ROXITX/tarp/docs/report/photos/photo_reader.jpg

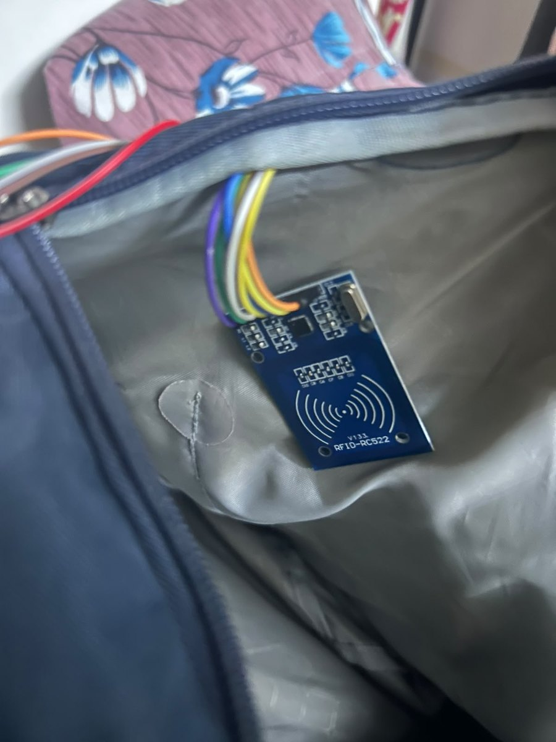
docs/report/photos/photo_reader.jpg
