ROXITX/tarp/docs/report/photos/photo_electronics.jpg

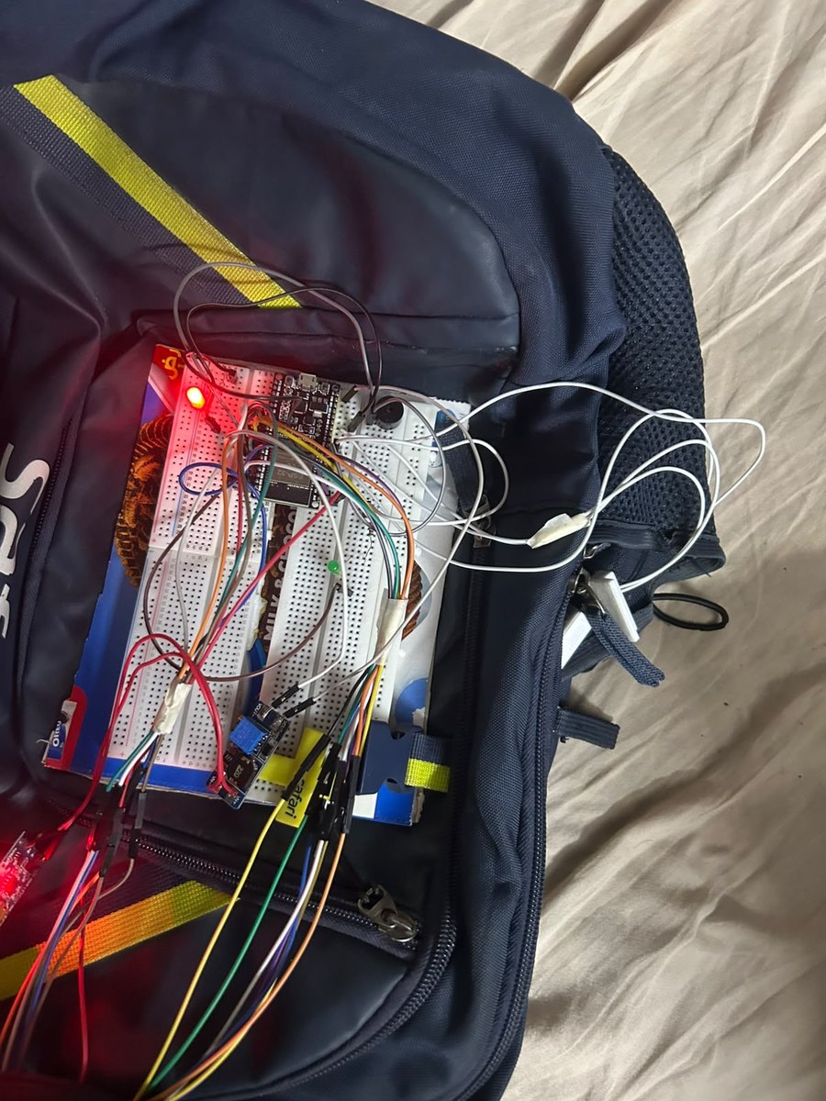
docs/report/photos/photo_electronics.jpg
