ROXITX/tarp/(commit log)

2026-10-07 Add SmartPack ESP32 firmware: toggle IN/OUT RFID scans, reed-switch closure verification, BLE protocol
    Claude-Session: https://claude.ai/code/session_01Sscac89Z6gGAA6gjTxH9m6
2026-10-07 Add Arduino IDE sketch; rename LINE_MAX to avoid system macro clash
    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
    [SmartPack.ino, ble_link.cpp, ble_link.h, indicator.h, pins.h, smartpack_core.h, storage.h]
2026-10-11 App: explicit delete-item button with confirmation (connected only); report: mobile-app comparison, hedge survey claims
    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
2026-10-11 Make compartment count configurable (wiring table + build setting); report describes 2-compartment prototype and scaling
    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
2026-10-12 Final project report in the sir's 17-section format with all diagrams, wiring diagram and photo placeholders
    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
2026-10-13 Report: remove forced page breaks and shrink UML figures to cut blank space (61 -> 54 pages)
    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
